prusa3d/Heatbed_MK52_magnetic/README.md

# Heatbed MK52 magnetic
## KiCad PCB layout

24V rev.05d
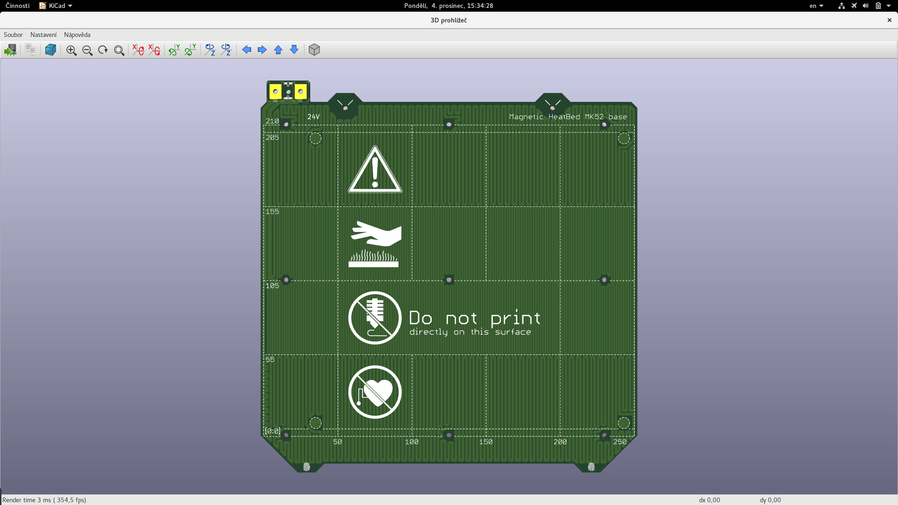
[picture p1: 24V_05d/Heatbed-MK52.png]


12V rev.05e
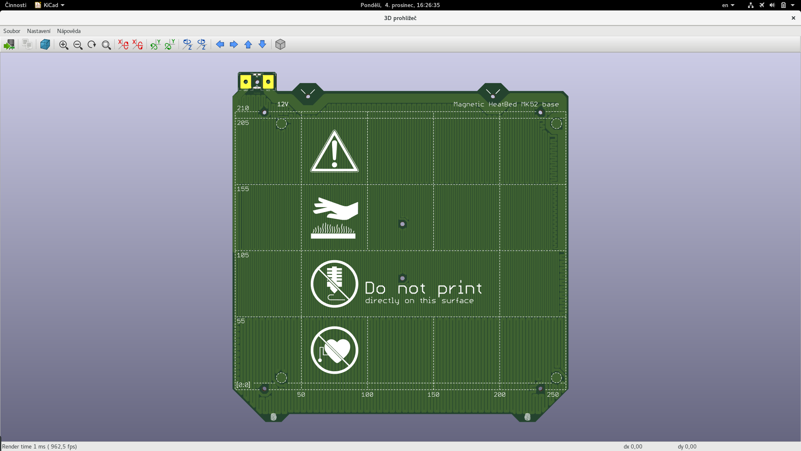
[picture p2: 12V_05e/Heatbed-MK52.png]
