prusa3d/Heatbed_MK52_magnetic/slots-for-magnets-05.dxf

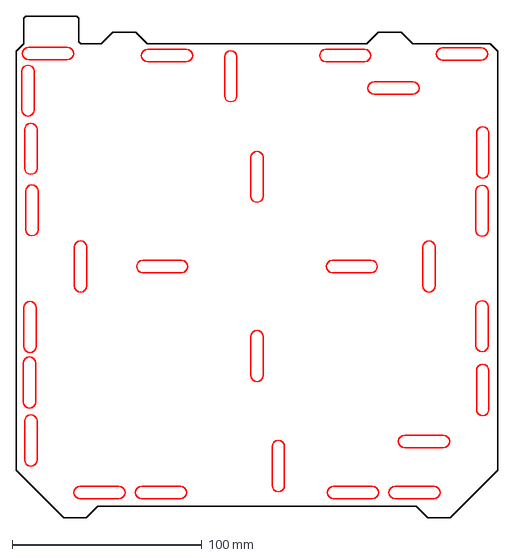
[picture p3: CAD file, 2017-12-05]
slots-for-magnets-05.dxf
254.0 x 264.4 mm
