prusa3d/Heatbed_MK52_magnetic/steel-sheet.dxf

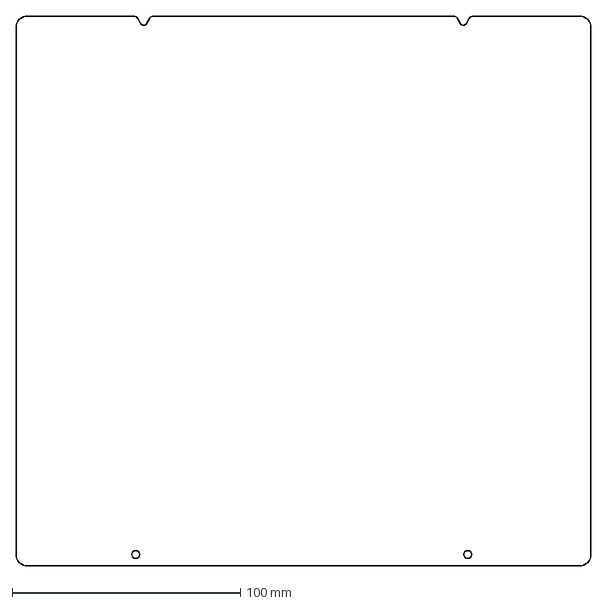
[picture p4: CAD file, 2017-12-04]
steel-sheet.dxf
252.0 x 241.0 mm
