prusa3d/Heatbed_MK52_magnetic/12V_05e/Heatbed-MK52.pdf

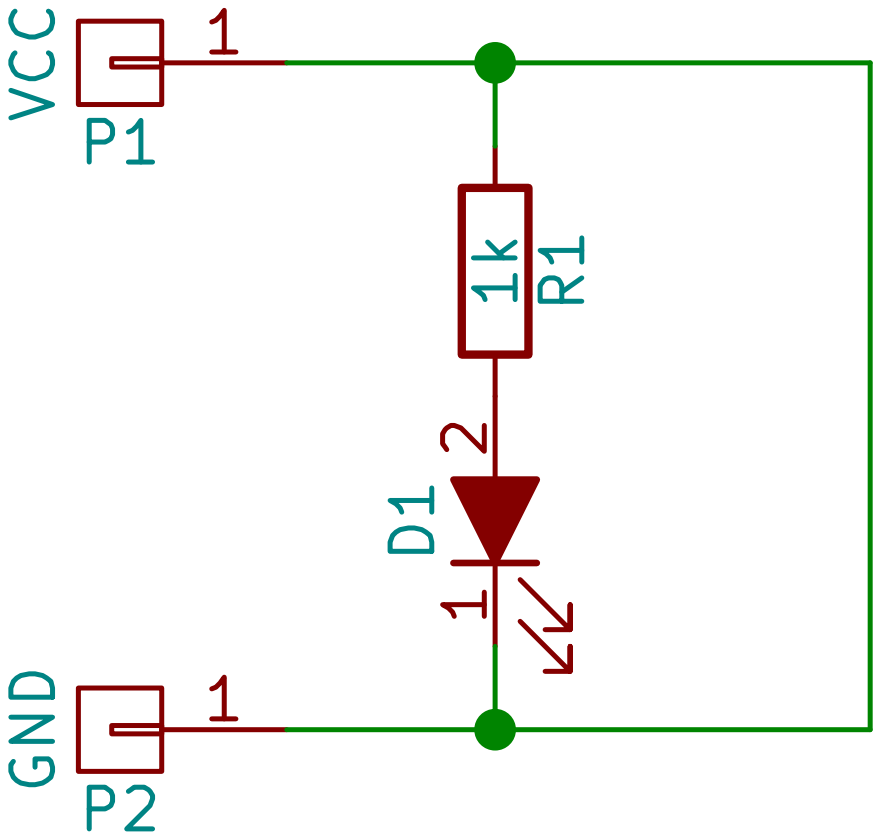
[picture p5: page 1]

prusa3d.com
#ok1hra
File: Heatbed-MK42.sch Sheet: / PRUSA RESEARCH s.r.o

Id: 1/1 Title: Magnetic HeatBed MK52
