prusa3d/Heatbed_MK52_magnetic/12V_05e/Heatbed-MK52.kicad_pcb

## KiCad design 12V_05e/Heatbed-MK52.kicad_pcb (2017-12-04)

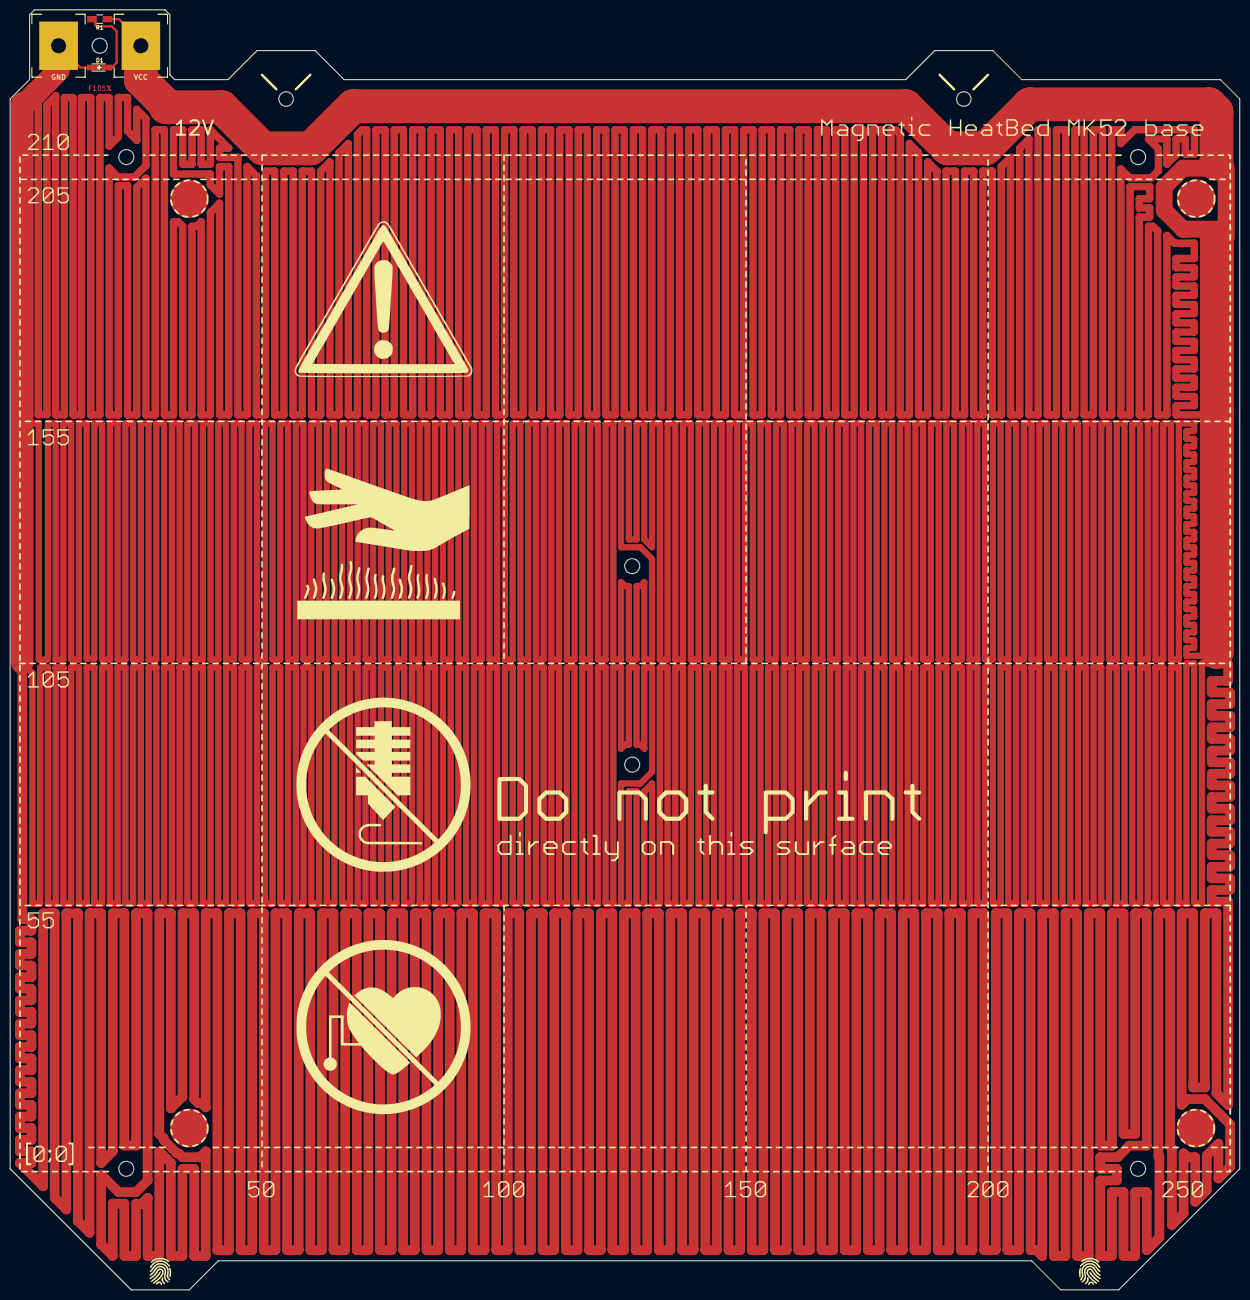
[picture p6: board Heatbed-MK52.kicad_pcb from above]

Board: 2 copper layers, 254.0 x 264.4 mm, 4 parts (0 on the bottom side), 2 nets.

Parts:
D1: LED_ALT; LED_0805
GND: GND; PCB-Large-pad
R1: 1k; R_0805
VCC: VCC; PCB-Large-pad

Connections:
unnamed: D1.1, GND.1, R1.1, VCC.1
unnamed: D1.2, R1.2
