prusa3d/Heatbed_MK52_magnetic/(threads)

Thread 1 (2017-12-15):

Loading /Users/danielkrah/Downloads/Heatbed_MK52_magnetic-master/24V_05d/Heatbed-MK52.sch | error: Start tag expected.

Moorviper, 2017-12-15:
Hi
I can't open the file

ok1hra, 2017-12-15:
We use newest version of Kicad, need compile from Git. More here
http://docs.kicad-pcb.org/doxygen/md_Documentation_development_compiling.html

Moorviper, 2017-12-15:
ah ok / opened with eagle now it is fine

Closed 2017-12-15.

Thread 2 (2018-03-16):

Library for silkscreen

madhunm, 2018-03-16:
@ok1hra

Can you please share the library file that has the top silk screen foot print? If not that, at least the source image / DXF used to create the silk screen?

Thanks!

ok1hra, 2018-03-19:
You can export from KiCad source

Closed 2018-03-19.

Thread 3 (2018-04-06):

Traces too close to Calibration points

CacikeOtoao, 2018-04-06:
As seen on mk-52 12volt beds the copper traces were too close to the calibration points causing the PINDA to not find the reference points and failing calibration, therefore retracing was needed. Please update files to reflect these changes to the community.

gregsaun, 2018-07-22:
I have received the first version of MK2.5 heated bed and 3 points have been cut out :

1st bed point 1:
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

1st bed point 2:
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

1st bed point 3:
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

1st bed point 4:
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

My first bed was twisted and could never have a good first layer across the bed. Prusa sent my a new one and this one does not have cuts :

2nd bed point 1:
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

2nd bed point 2:
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

2nd bed point 3:
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

2nd bed point 4:
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

Does this mean some files are missing or not synchronized anymore?

gregsaun, 2018-07-22:
This could explain these issues as well :

https://github.com/prusa3d/Prusa-Firmware/issues/895
https://github.com/prusa3d/Prusa-Firmware/issues/764
https://github.com/prusa3d/Prusa-Firmware/issues/616

matthew-humphrey, 2018-07-24:
Good work troubleshooting this guys. Up-voting to hopefully draw a response from Prusa.

ok1hra, 2018-07-24:
This problem was solved in firmware [MK2.5 (3.1.4-RC1)](https://github.com/prusa3d/Prusa-Firmware/releases/tag/v3.1.4-RC1) and later also [MK3 and MK2.5 (3.2.0-RC1)](https://github.com/prusa3d/Prusa-Firmware/releases/tag/v3.2.0-RC1).
Therefore was no need changed Heatbed layout.

zbrozek, 2018-07-24:
I was completely unable to complete a calibration with my brand-new mk52 12v bed with firmwares 3.1.3, 3.1.4, 3.2.0, 3.3.0, and 3.3.1 until I cut away the small section to the right of the probe point.

I do not believe that *any* firmware solution is possible. It is possible to traverse X at the highest Z at which a perfectly-centered PINDA just triggers and not have the PINDA output go high until it's past the edge of the board.

zbrozek, 2018-07-25:
Here's a log from firmware 3.3.1 failing XYZ calibration on a stock 12v mk52 bed. Notice the bad 2D scan of point three after a false trigger during the initial spiraling search. This problem is **not fixed.**

[fw_3.3.1_xyz.log](https://github.com/prusa3d/Heatbed_MK52_magnetic/files/2226058/fw_3.3.1_xyz.log)

CacikeOtoao, 2018-07-25:
So a design flaw gets compensated for in Firmware and doesn't get an actual fix. They are surely flexing the OSHW licensing.

zbrozek, 2018-07-25:
I don't think there's any issue with following the license or the spirit of it. But I do think that the bug isn't closed because no hardware fix is in place, and the firmware fix doesn't actually work. This is a negative-margin design and a minor tweak can fix it.

sirBlargh, 2018-07-26:
Did my upgrade 6 days ago. It also failed at point 3 so I Talked with support.  First they suggested that I should adjust PINDA but that did not help. They then asked me to verify that it was 100mm from the back of the Z-frame to the closest part of the back feet. I had 101mm and changing that to 100mm solved it for me.

Closed 2018-07-24.

Thread 4 (2018-04-12):

My resistor measures 2K on my 24v board, but the 24v spec says 1K

rrauenza, 2018-04-12:
Is this a mistake in what was published?  It kind of makes sense that the 24v would be 2X the 12v one...

ok1hra, 2018-07-24:
Yes you are right :)

Closed 2018-07-24.

Thread 5 (2024-06-19):

adapt /modify to other dimensional meassurements

sl1pkn07, 2024-06-19:
Hi

i want make a custom MK52 24V bed for adapt to other printer.

the new bed meassurements is 235x235, with 4  4mm holes with 32.5mm distance from each side (basically for the Ender 3 printer)

how to edit the PCB for adapt to new meassurements with kicad witout edit any electrical properties? (resistance, inductance, watever...)

greetings
